sngmn7/STM32_CAN_RTOS_ETHERNET/rear_node_board/FrontZone_Carrier_설계기준.xlsx

Sheet: 00_개요
Front Zone 캐리어 보드 — 설계 기준 / 핀맵 / BOM
출처 | ZoneController_Front_H723.ioc / F407_Front.ioc (업로드본에서 직접 추출)
Rear 보드와의 차이 | MCU가 F446RET6(LQFP64) → F407VGT6(LQFP100). CAN 버스 1개. 모터 드라이버·ADC 3ch·DHT11이 새로 추가됨
MCU 구성 | U2 = STM32F407VGT6 (LQFP-100, 베어칩). H723은 Nucleo-144 모듈을 핀헤더로 연결
CAN 버스 | 250 kbit/s 1개. H723 FDCAN2(PB5/PB6) ↔ F407 CAN1(PD0/PD1) + 외부 확장 커넥터
트랜시버 | SN65HVD230D (SOIC-8, 3.3V) × 2개 — Rear 보드와 동일 부품
전원 | J1 VIN 5V → U1 AMS1117-3.3 → 3.3V. Rear 보드와 동일 구조
★ VCAP 주의 | F407VGT6(LQFP100)은 VCAP 핀이 2개 → 2.2uF를 각각 1개씩, 총 2개. Rear의 F446(1핀·4.7uF)과 다름
★ 신규 블록 | L298N급 모터 드라이버 I/F (ENA/ENB/IN1~4), ADC 3ch (조향/브레이크/가속), DHT11, 방향지시등, 헤드램프
시트 안내 | 01=F407 핀맵, 02=H723/커넥터, 03=넷리스트, 04=BOM, 05=회로 주의사항, 06=연결금지핀

Sheet: 01_F407_핀맵
MCU 핀 | 신호 (.ioc) | ioc 라벨 | 역할 | 캐리어 네트명 | 연결 대상 | 필요 수동소자 | 비고
PD1 | CAN1_TX | - | CAN 송신 | F407_CAN_TX | U4.1 (D) | R 0Ω (33Ω 대체) | 트랜시버 최단거리
PD0 | CAN1_RX | - | CAN 수신 | F407_CAN_RX | U4.4 (R) | R 0Ω
PA1 | ADC1_IN1 | STEERING_ADC | 조향 포지션 입력 | ADC_STEER | J_ADC.2 | R 1k 직렬 + C 100nF↓GND | RC 필터. 포텐셔미터 와이퍼
PC1 | ADC1_IN11 | BRAKE_ADC | 브레이크 페달 입력 | ADC_BRAKE | J_ADC.3 | R 1k + C 100nF | 동일
PC2 | ADC1_IN12 | ACCEL_ADC | 가속 페달 입력 | ADC_ACCEL | J_ADC.4 | R 1k + C 100nF | 동일
PE4 | GPIO_Output | ACT_ENA | 모터 A 인에이블(PWM) | ACT_ENA | J_MOT.1 | R 100Ω 직렬 | L298N ENA
PE5 | GPIO_Output | ACT_ENB | 모터 B 인에이블(PWM) | ACT_ENB | J_MOT.2 | R 100Ω | L298N ENB
PE12 | GPIO_Output | ACT_IN1 | 모터 A 방향1 | ACT_IN1 | J_MOT.3 | R 100Ω
PE13 | GPIO_Output | ACT_IN2 | 모터 A 방향2 | ACT_IN2 | J_MOT.4 | R 100Ω
PE14 | GPIO_Output | ACT_IN3 | 모터 B 방향1 | ACT_IN3 | J_MOT.5 | R 100Ω
PE15 | GPIO_Output | ACT_IN4 | 모터 B 방향2 | ACT_IN4 | J_MOT.6 | R 100Ω
PE7 | GPIO_Output | TURN_LEFT_LED | 좌측 방향지시등 | TURN_L | R 330Ω → LED_L → GND | R 330Ω | 12V 실제 램프면 MOSFET로 교체
PE8 | GPIO_Output | TURN_RIGHT_LED | 우측 방향지시등 | TURN_R | R 330Ω → LED_R → GND | R 330Ω | 동일
PE10 | GPIO_Output | HEADLAMP_OUT | 헤드램프 출력 | HEADLAMP | R 330Ω → LED_H → GND | R 330Ω | 동일
PE9 | GPIO_Input | TURN_SWITCH | 방향지시 스위치 | TURN_SW | SW2 → GND | R 10k↑3V3 + C 100nF + R 100Ω | ioc는 내부 PULLUP이지만 외부 풀업 권장
PE11 | GPIO_Output(OD) | DHT11_DATA | 온습도 센서 데이터 | DHT11_DATA | J_DHT.2 | R 4.7k↑3V3 (필수) | 1-wire 오픈드레인 → 풀업 없으면 통신 불가
PA13 | SWDIO | SWDIO | 디버그 | F407_SWDIO | J_SWD.4 | -
PA14 | SWCLK | SWCLK | 디버그 | F407_SWCLK | J_SWD.2 | -
PB3 | SWO | SWO | 디버그 트레이스 | F407_SWO | J_SWD.6 | -
NRST | - | - | 리셋 | F407_NRST | J_SWD.5 + SW1 | C 100nF↓GND | 리셋 버튼 옵션
BOOT0 | - | - | 부트 모드 | F407_BOOT0 | R 10k↓GND | R 10k | 플래시 부팅 고정
PB2 | GPIO_Input | BOOT1 | 부트1 | - | R 10k↓GND | R 10k | F407은 BOOT1=PB2. 풀다운 필수
PH0/PH1 | RCC_OSC_IN/OUT | - | 8MHz 크리스탈 | OSC_IN/OSC_OUT | Y1 | C 10pF × 2 | 칩 최근접 배치
VCAP_1 | - | - | 내부 레귤레이터 | VCAP1 | C 2.2uF ↓GND | 2.2uF | ★ F407은 VCAP 2개
VCAP_2 | - | - | 내부 레귤레이터 | VCAP2 | C 2.2uF ↓GND | 2.2uF | ★ 각각 별도로 달 것
VDDA/VREF+ | - | - | 아날로그 전원 | 3V3A | FB1 경유 3.3V | FB 1kΩ@100MHz + 100nF + 1uF | ADC 3ch 쓰므로 분리 권장
VDD ×여러개 | - | - | 디지털 전원 | +3.3V | 각 핀마다 100nF | 100nF × VDD 개수 | LQFP100은 VDD가 5개 내외
VSS ×여러개 | - | - | 그라운드 | GND | GND 플레인 | - | 전부 플레인 연결

Sheet: 02_커넥터
레퍼런스 | 커넥터 | 핀 수 | 핀 배열 | 용도 | 비고
J2 | H723 NUCLEO-144 I/F | 4 | 1=FDCAN2_TX(PB6), 2=FDCAN2_RX(PB5), 3=GND, 4=GND | H723 모듈 연결 | Nucleo CN12-17(PB6), CN12-29(PB5)에서 점퍼선
J3 | SWD - F407 | 6 | 1=+3.3V, 2=SWCLK, 3=GND, 4=SWDIO, 5=NRST, 6=SWO | ST-Link 디버그 | Rear 보드 J3/J4와 동일 배열
J4 | UART CONSOLE | 3 | 1=TX(PA2/USART2), 2=RX(PA3), 3=GND | 디버그 콘솔 | ※ .ioc에 USART 미설정 — 쓰려면 CubeMX에서 추가
J5 | CAN 250k 외부 | 3 | 1=CANH, 2=CANL, 3=GND | CAN 버스 확장/모터노드 | 스크류 터미널 권장
J6 | MOTOR DRIVER | 7 | 1=ENA, 2=ENB, 3=IN1, 4=IN2, 5=IN3, 6=IN4, 7=GND | L298N 등 드라이버 보드 | 드라이버 전원은 별도 공급
J7 | ADC 입력 | 5 | 1=3.3V, 2=STEER, 3=BRAKE, 4=ACCEL, 5=GND | 페달/조향 센서 | 포텐셔미터 3개
J8 | DHT11 | 3 | 1=3.3V, 2=DATA, 3=GND | 온습도 센서 | DATA에 4.7k 풀업 필수
J1 | VIN 5V | 2 | 1=VCC(5V), 2=GND | 전원 입력 | 터미널블록
J9 | 램프 출력 | 4 | 1=TURN_L, 2=TURN_R, 3=HEADLAMP, 4=GND | 외부 램프 인출 | 온보드 LED와 병렬 or 대체

Sheet: 03_넷리스트
넷명 | 블록 | 연결 1 | 연결 2 | 연결 3 | 수동소자 | 비고
CANH | CAN | U3.7 | U4.7 | J5.1 | RT1a/RT2a 60.4Ω, ESD D1 | 차동페어. 데이지체인
CANL | CAN | U3.6 | U4.6 | J5.2 | RT1b/RT2b 60.4Ω, ESD D1 | CANH와 페어 라우팅
CAN_SPLIT | CAN | 종단 중점 | C 4.7nF | GND | C 4.7nF | 스플릿 종단
H723_CAN_TX | CAN | J2.1 | U3.1 |  | R 0Ω
H723_CAN_RX | CAN | J2.2 | U3.4 |  | R 0Ω
F407_CAN_TX | CAN | U2.PD1 | U4.1 |  | R 0Ω
F407_CAN_RX | CAN | U2.PD0 | U4.4 |  | R 0Ω
VCC | 전원 | J1.1 | U1.3 (AMS IN) |  | C 10uF + 100nF | 5V 입력
+3.3V | 전원 | U1.2 (OUT) | U2 VDD 전체, U3.3, U4.3 | 각 커넥터 3.3V핀 | C 10uF + 100nF ×n | 메인 3.3V
3V3A | 전원 | FB1 출력 | U2 VDDA/VREF+ |  | FB 1k@100MHz, C 100nF+1uF | 아날로그 분리
GND | 전원 | 전 부품 GND | GND 플레인 |  | - | 단일 플레인
RS_1 / RS_2 | 모드 | U3.8 / U4.8 | GND |  | R 0Ω ×2 | 고속모드
ADC_STEER | 센서 | J7.2 | U2.PA1 |  | R 1k 직렬, C 100nF↓GND | RC 필터
ADC_BRAKE | 센서 | J7.3 | U2.PC1 |  | R 1k, C 100nF
ADC_ACCEL | 센서 | J7.4 | U2.PC2 |  | R 1k, C 100nF
DHT11_DATA | 센서 | J8.2 | U2.PE11 |  | R 4.7k → 3.3V | ★ 풀업 없으면 동작 안 함
ACT_ENA~IN4 | 구동 | J6.1~6 | U2.PE4/5/12/13/14/15 |  | R 100Ω ×6 | 직렬 보호
TURN_L | 출력 | U2.PE7 | R→LED_L→GND | J9.1 | R 330Ω
TURN_R | 출력 | U2.PE8 | R→LED_R→GND | J9.2 | R 330Ω
HEADLAMP | 출력 | U2.PE10 | R→LED_H→GND | J9.3 | R 330Ω
TURN_SW | 입력 | U2.PE9 | R 100Ω → SW2 → GND |  | R 10k↑3V3, C 100nF↓GND | 디바운스
F407_BOOT0 | 부트 | U2 BOOT0 | GND |  | R 10k | 플래시 부팅
BOOT1 | 부트 | U2.PB2 | GND |  | R 10k | ★ F407 전용, 잊기 쉬움
OSC_IN/OUT | 클럭 | U2.PH0/PH1 | Y1.1/Y1.3 |  | C 10pF ×2, Y1 GND패드 | 칩 최근접
VCAP1 / VCAP2 | 전원 | U2 VCAP_1 / VCAP_2 | GND |  | C 2.2uF ×2 | ★ 각각 별도

Sheet: 04_BOM
구분 | 레퍼런스 | 부품 | 값 / 규격 | 패키지 | 수량 | 비고
IC | U1 | AMS1117-3.3 | 5V→3.3V LDO, 1A | SOT-223 | 1 | Rear 보드와 동일
IC | U2 | STM32F407VGT6 | LQFP-100, 0.5mm 피치 | LQFP-100 | 1 | ★ 손납땜 불가 — 리플로우/SMT 서비스
IC | U3, U4 | SN65HVD230D | 3.3V CAN 트랜시버 | SOIC-8 | 2 | Rear에서 4개 썼던 것과 동일
크리스탈 | Y1 | ECS-80-10-30B-CWN-TR | 8MHz, 4패드 SMD | 3225 | 1 | Rear와 동일 부품
커패시터 | C(VCAP) | MLCC X5R/X7R 6.3V↑ | 2.2uF | 0805 | 2 | ★ VCAP_1/VCAP_2 각각
커패시터 | C(OSC) | MLCC C0G/NP0 | 10pF | 0805 | 2 | 크리스탈 로드캡
커패시터 | C(VDD) | MLCC X7R | 100nF | 0805 | 8 | VDD 핀마다 1개 + 여유
커패시터 | C(BULK) | MLCC / 탄탈 | 10uF | 0805 | 4 | 5V, 3.3V, 3V3A, 모터I/F
커패시터 | C(VDDA) | MLCC | 1uF | 0805 | 1 | 아날로그 전원
커패시터 | C(ADC) | MLCC | 100nF | 0805 | 3 | ADC RC 필터
커패시터 | C(SW/RST) | MLCC | 100nF | 0805 | 3 | 스위치 디바운스 + NRST
커패시터 | C(SPLIT) | MLCC | 4.7nF | 0805 | 2 | CAN 스플릿 종단
페라이트 | FB1 | ILHB0805ER102VGP13 | 1kΩ@100MHz, 0.5A | 0805 | 1 | VDDA 분리. Rear와 동일
저항 | RT1a/b, RT2a/b | 칩 저항 1% | 60.4Ω | 0805 | 4 | 스플릿 종단. 버스 양 끝만
저항 | R(CAN) | 칩 저항 | 0Ω (33Ω 대체) | 0805 | 4 | TXD/RXD 직렬
저항 | R(Rs) | 칩 저항 | 0Ω | 0805 | 2 | 트랜시버 8번 → GND
저항 | R(ADC) | 칩 저항 J급 | 1k | 0805 | 3 | ADC 직렬
저항 | R(DHT) | 칩 저항 | 4.7k | 0805 | 1 | ★ DHT11 풀업 필수
저항 | R(ACT) | 칩 저항 | 100Ω | 0805 | 6 | 모터 신호 직렬
저항 | R(LED) | 칩 저항 | 330Ω | 0805 | 4 | LED 전류제한 (PWR 포함)
저항 | R(PU/PD) | 칩 저항 | 10k | 0805 | 4 | BOOT0, BOOT1, TURN_SW, 여유
저항 | R(SW) | 칩 저항 | 100Ω | 0805 | 1 | 스위치 직렬 보호
LED | LED_L/R/H/PWR | LED 3mm | 황/황/백/적 | THT or 0805 | 4 | 방향지시 2 + 헤드램프 + 전원
다이오드 | D1 | PESD1CAN | CAN ESD 보호 | SOT-23 | 1 | J5 커넥터 근처
커넥터 | J1 | 스크류 터미널 2P | 5.08mm | THT | 1 | VIN 5V
커넥터 | J5 | 스크류 터미널 3P | 5.08mm | THT | 1 | CAN 외부
커넥터 | J2 | 핀헤더 4P | 2.54mm | THT | 1 | H723 I/F
커넥터 | J3 | 핀헤더 6P | 2.54mm | THT | 1 | SWD
커넥터 | J4, J8 | 핀헤더 3P | 2.54mm | THT | 2 | UART, DHT11
커넥터 | J6 | 핀헤더 7P | 2.54mm | THT | 1 | 모터 드라이버
커넥터 | J7 | 핀헤더 5P | 2.54mm | THT | 1 | ADC 입력
커넥터 | J9 | 핀헤더 4P | 2.54mm | THT | 1 | 램프 출력
스위치 | SW1, SW2 | 택트 스위치 6mm | SPST | THT | 2 | RESET, TURN
테스트 | TP1~TP6 | 테스트 포인트 | - | SMD | 6 | CANH/L, 3V3, 3V3A, 5V, GND

Sheet: 05_회로_주의사항
# | 항목 | 내용 | 우선순위
1 | ★ VCAP 2개 | F407VGT6(LQFP100)은 VCAP_1, VCAP_2 두 핀이라 2.2uF를 각각 1개씩 총 2개. Rear의 F446(VCAP 1개·4.7uF)과 혼동하면 부팅 불안정. 칩 핀에서 5mm 이내. | 필수
2 | ★ BOOT1 = PB2 | F407은 PB2가 BOOT1 겸용이다. 10k로 GND에 떨어뜨리지 않으면 부트 모드가 튈 수 있다. F446에는 없던 항목이라 빠뜨리기 쉬움. | 필수
3 | ★ DHT11 풀업 | PE11은 오픈드레인 1-wire. 4.7k 풀업을 3.3V로 넣지 않으면 통신 자체가 안 된다. 모듈형 DHT11이면 이미 있는지 확인하고 있으면 DNP. | 필수
4 | LQFP-100 실장 | 0.5mm 피치라 인두 손납땜은 사실상 불가능. SMT 서비스나 핫에어 필수. 부품 발주 시 이 부분 계획부터 세울 것. | 필수
5 | VDD 디커플링 | LQFP100은 VDD 핀이 5개 내외. 각 VDD 핀마다 100nF을 최단거리로. 하나만 달고 넘어가면 고속 스위칭에서 리셋이 걸린다. | 필수
6 | VDDA 분리 | ADC를 3채널 쓰므로 VDDA/VREF+를 페라이트비드로 3.3V에서 분리하고 100nF+1uF. 안 하면 모터 PWM 노이즈가 ADC 값에 그대로 실린다. | 필수
7 | 모터 노이즈 격리 | L298N 계열은 스위칭 노이즈가 크다. 모터 드라이버 전원은 이 보드에서 끌어오지 말고 별도 공급하고, J6는 신호+GND만. GND는 한 점에서만 합류시킬 것. | 필수
8 | CAN 종단 | 노드가 H723·F407 2개뿐이면 양 끝 = 이 보드 양쪽. 외부 모터 노드를 J5에 달면 종단 위치가 바뀐다. 전원 끄고 CANH-CANL 재서 60Ω 확인. | 필수
9 | 차동 페어 | CANH/CANL 같은 폭·같은 간격으로 나란히, 길이 ±5mm, 비아 최소. 넷클래스 CAN(0.3mm/DP 0.3·0.2)로 지정. | 필수
10 | 스텁 길이 | 버스 본선에서 트랜시버까지 30mm 이내. U3 → U4 → J5 데이지체인. T분기 금지. | 필수
11 | Rs 핀 | U3/U4 8번을 0Ω으로 GND에. 오픈으로 두면 동작 불능. | 필수
12 | 크리스탈 배치 | Y1을 PH0/PH1 핀 최근접에, 로드캡 10pF 2개도 바로 옆. 크리스탈 아래 다른 신호 배선 금지, GND로 감쌀 것. | 필수
13 | ADC 입력 보호 | 포텐셔미터 와이퍼가 튀면 ADC 핀이 상한다. 1k 직렬 + 100nF은 필터 겸 보호. 입력이 5V 스윙이면 분압 필수(F407 ADC는 3.3V 초과 금지). | 필수
14 | AMS1117 발열 | 5V→3.3V 강하에 전류가 붙으면 SOT-223이 뜨거워진다. 탭 핀 아래 구리 면적을 넓게 잡고 비아를 여러 개 박아 방열. | 권장
15 | 램프 출력 | LED 직결이면 330Ω. 실제 12V 차량 램프면 2N7002/AO3400 로우사이드 + 게이트 10k 풀다운 + 플라이백 다이오드. | 일반
16 | TURN_SW | ioc는 내부 PULLUP이지만 외부 10k+100nF+100Ω을 넣어두는 게 노이즈에 강하다. Rear 보드 PC3 때와 같은 이유. | 권장
17 | UART 콘솔 | 현재 .ioc에 USART가 설정돼 있지 않다. J4를 살리려면 CubeMX에서 USART2(PA2/PA3) 등을 먼저 활성화할 것. 아니면 J4 미실장. | 주의
18 | H723 이더넷 핀 | PA1/PA2/PA7/PC1/PC4/PC5/PG11/PG13/PB13은 Nucleo 온보드 PHY 전용. J2에서 절대 뽑지 말 것. | 필수
19 | 전원 도메인 | H723은 자기 USB로 급전. 이 보드 3.3V와 H723 3V3를 묶지 말고 GND와 CAN 신호만 공유. | 필수
20 | 실크 표기 | J6 핀 순서(ENA/ENB/IN1~4/GND)와 J7(3V3/STEER/BRAKE/ACCEL/GND)을 실크에 반드시 인쇄. 핀 많아서 실물에서 100% 헷갈린다. | 권장
21 | GND 플레인 | 4층이면 In1.Cu 통짜 GND. F.Cu에도 GND 존을 깔아야 SMD 패드가 붙는다 — Rear 보드에서 겪었던 그 문제. | 필수

Sheet: 06_연결금지핀
대상 | 핀 | 원래 용도 | 이유 | 조치
H723 (J2) | PA1, PA2, PA7, PC1, PC4, PC5, PG11, PG13, PB13 | ETH RMII | Nucleo 온보드 LAN8742 전용 | 미연결
H723 (J2) | PD8, PD9 | USART3 VCP | ST-Link 가상 COM | 미연결
H723 (J2) | PA13, PA14 | SWD | 디버거 전용 | 미연결
F407 (U2) | PA9~PA12 | USB OTG FS | .ioc에 USB Host 활성 — 안 쓸 거면 CubeMX에서 끄고, 쓸 거면 USB 커넥터 추가 필요 | 결정 필요
F407 (U2) | PA4~PA7, PC7, PC10, PC12, PE3, PE1 | I2S3 / SPI1 / LIS302DL | Discovery 보드 잔재. 베어칩에는 해당 부품 없음 | CubeMX에서 정리 권장
F407 (U2) | PB10, PC3 | I2S2 (마이크) | Discovery 마이크 잔재 | 정리 권장
F407 (U2) | PB6, PB9 | I2C1 (오디오) | Discovery 코덱용 라벨. 다른 I2C 센서에 재사용 가능 | 재활용 검토
F407 (U2) | PD12~PD15 | Discovery LED | 베어칩엔 온보드 LED 없음 — 원하면 새 LED 달아도 됨 | 선택
F407 (U2) | PA0 | B1 버튼 | Discovery 버튼 잔재 | 선택
F407 (U2) | PC0, PD5 | USB 전원 스위치/OC | Discovery 전용 | 미연결
F407 (U2) | PD4 | Audio_RST | Discovery 코덱 리셋 | 미연결
