sngmn7/STM32_CAN_RTOS_ETHERNET/rear_node_board/공용보드_추가설계_RearFront_v2.xlsx

Sheet: 00_개요
Rear / Front 공용 보드 — 기존 rear_node_board.kicad_sch에 추가할 것
출처 | rear_node_board.kicad_sch (현재 상태) + F407_Front.ioc + ZoneController_Front_H723.ioc
핵심 결론 | MCU·전원·CAN·크리스탈·SWD·UART·램프 3종은 이미 다 있음. 추가로 필요한 건 U7 쪽 10핀 + 커넥터 3개뿐
추가 핀 수 | 10개 (ADC 3 + 모터 6 + DHT11 1) — 전부 U7(NODE) 여유핀에 배치
이미 있어서 재사용 | 깜빡이 좌/우 + 브레이크등(3종 전부), 방향 스위치, CAN, 상태 LED — Front와 Rear의 램프 구성이 완전히 동일
역할 배치 원칙 | Front 모드에서는 U7 하나가 기존 F407 역할을 전부 대신함. U4는 Front 보드에서 미실장(DNP) 가능
CAN 버스 | 현재 CANH_1/CANL_1(500k, U12+U13+J5) / CANH_2/CANL_2(250k, U10+U11) 2개. Front는 250k 버스만 쓰면 됨 → 변경 없음
H723 커넥터 | J2에 FDCAN1·FDCAN2 4핀 다 나와 있음. Front H723은 FDCAN2만 쓰므로 그대로 호환 → 변경 없음
Rear에만 있는 것 | BNO085(J6/J7), HC-SR04(J11), 서보(J10) — Front에서는 미실장으로 두면 됨
Front에만 있는 것 | ADC 3ch, 모터 드라이버, DHT11 — Rear에서는 미실장으로 두면 됨. 헤드램프는 실물 LED가 없으므로 제외
시트 안내 | 01=추가 핀맵, 02=재사용 핀, 03=추가 커넥터, 04=추가 BOM, 05=주의사항, 06=U7 남는 핀

Sheet: 01_추가핀맵_U7
U7 핀번호 | 포트 | 새 넷명 | 역할 (Front) | F407 원본 핀 | 대체 기능 | 필요 수동소자 | 연결 대상 | 비고
8 | PC0 | ADC_STEER | 조향 포지션 | PA1 (IN1) | ADC1_IN10 | R 1k 직렬 + C 100nF ↓GND | J12.2 | F407은 IN1이었으나 PA1이 이미 LED_RIGHT라 IN10으로 이동
9 | PC1 | ADC_BRAKE | 브레이크 페달 | PC1 (IN11) | ADC1_IN11 | R 1k + C 100nF | J12.3 | ★ F407과 채널 번호까지 동일 — 펌웨어 그대로
10 | PC2 | ADC_ACCEL | 가속 페달 | PC2 (IN12) | ADC1_IN12 | R 1k + C 100nF | J12.4 | ★ F407과 동일
26 | PB0 | ACT_ENA | 모터 A 인에이블 | PE4 | TIM3_CH3 (PWM) | R 100Ω 직렬 | J13.1 | PWM 필요해서 타이머 채널로 배정
27 | PB1 | ACT_ENB | 모터 B 인에이블 | PE5 | TIM3_CH4 (PWM) | R 100Ω | J13.2 | ENA와 같은 TIM3라 설정 간단
33 | PB12 | ACT_IN1 | 모터 A 방향1 | PE12 | GPIO_Output | R 100Ω | J13.3
34 | PB13 | ACT_IN2 | 모터 A 방향2 | PE13 | GPIO_Output | R 100Ω | J13.4
35 | PB14 | ACT_IN3 | 모터 B 방향1 | PE14 | GPIO_Output | R 100Ω | J13.5
36 | PB15 | ACT_IN4 | 모터 B 방향2 | PE15 | GPIO_Output | R 100Ω | J13.6 | PB12~15 연속 배치라 배선·펌웨어 다 깔끔
39 | PC8 | DHT11_DATA | 온습도 데이터 | PE11 | TIM8_CH3 (캡처 가능) | R 4.7k ↑3V3 (필수) | J14.2 | ★ 풀업 없으면 통신 자체가 안 됨

Sheet: 02_재사용핀
U7 핀번호 | 포트 | 현재 넷명 (Rear) | Rear 역할 | Front 역할 | F407 원본 | 조치
14 | PA0 | LED_LEFT | 좌측 깜빡이 | 좌측 깜빡이 (PE7) | PE7 | ★ Front/Rear 둘 다 동일 기능. 넷명을 TURN_LEFT로 바꾸면 더 명확
15 | PA1 | LED_RIGHT | 우측 깜빡이 | 우측 깜빡이 (PE8) | PE8 | ★ Front/Rear 둘 다 동일 기능
11 | PC3 | TOGGLE_SW | 토글 스위치 | TURN_SWITCH | PE9 | 그대로 사용. 이미 10k 풀업+디바운스 붙어 있음
21 | PA5 | LED_STATUS | 상태 표시 | 상태 표시 | - | 그대로 사용
20 | PA4 | LED_BRAKE | 브레이크등 | 브레이크등 | - | ★ Front도 브레이크등이 있으므로 그대로 사용. Front/Rear LED 3종이 완전히 동일
44 | PA11 | F446_CAN2_RX | CAN 250k 수신 | CAN 수신 | PD0 | 그대로. Front H723도 FDCAN2(250k)라 버스 일치
45 | PA12 | F446_CAN2_TX | CAN 250k 송신 | CAN 송신 | PD1 | 그대로
16 | PA2 | UART_TX_2 | 콘솔 TX | 콘솔 TX | 미설정 | 그대로. Front .ioc엔 USART가 없으니 CubeMX에서 켜면 됨
17 | PA3 | UART_RX_2 | 콘솔 RX | 콘솔 RX | 미설정 | 그대로
46 | PA13 | ND_SWDIO | 디버그 | 디버그 | PA13 | 그대로
49 | PA14 | ND_SWCLK | 디버그 | 디버그 | PA14 | 그대로
55 | PB3 | ND_SWO | 디버그 트레이스 | 디버그 트레이스 | PB3 | 그대로
5 | PH0 | ND_OSC_IN | 8MHz | 8MHz | PH0 | 그대로. Front도 HSE 8MHz로 동일
6 | PH1 | ND_OSC_OUT | 8MHz | 8MHz | PH1 | 그대로
29 | PB10 | US_TRIG | 초음파 트리거 | 미사용 | - | Rear 전용. Front에서는 J11 미실장
58 | PB6 | US_ECHO | 초음파 에코 | 미사용 | - | Rear 전용
61 | PB8 | I2C1_SCL | IMU | 미사용 | - | Rear 전용. Front에서는 U8 소켓 미실장
62 | PB9 | I2C1_SDA | IMU | 미사용 | - | Rear 전용
56 | PB4 | BNO_RST | IMU 리셋 | 미사용 | - | Rear 전용
57 | PB5 | BNO_INT | IMU 인터럽트 | 미사용 | - | Rear 전용

Sheet: 03_추가커넥터
레퍼런스 | 이름 | 핀 수 | 핀 배열 | 용도 | 실장 조건
J12 | ADC INPUT | 5 | 1=+3.3V, 2=STEER, 3=BRAKE, 4=ACCEL, 5=GND | 페달/조향 포텐셔미터 | Front만 실장
J13 | MOTOR DRIVER | 7 | 1=ENA, 2=ENB, 3=IN1, 4=IN2, 5=IN3, 6=IN4, 7=GND | L298N 등 드라이버 | Front만 실장
J14 | DHT11 | 3 | 1=+3.3V, 2=DATA, 3=GND | 온습도 센서 | Front만 실장
- | (기존) J1~J11 | - | 변경 없음 | 전원/H723/SWD/CAN/UART/IMU/초음파/서보 | 역할별 선택 실장

Sheet: 04_추가BOM
구분 | 레퍼런스(예시) | 부품 | 값 | 패키지 | 수량 | 용도
저항 | R16~R18 | 칩 저항 J급 | 1k | 0805 | 3 | ADC 3ch 직렬 보호 + RC 필터
커패시터 | C28~C30 | MLCC X7R | 100nF | 0805 | 3 | ADC 3ch 필터 → GND
저항 | R19~R24 | 칩 저항 J급 | 100Ω | 0805 | 6 | 모터 드라이버 신호 6개 직렬 보호
저항 | R25 | 칩 저항 J급 | 4.7k | 0805 | 1 | ★ DHT11 데이터 풀업 → 3.3V
커넥터 | J12 | 핀헤더 5P | 2.54mm | THT | 1 | ADC 입력
커넥터 | J13 | 핀헤더 7P | 2.54mm | THT | 1 | 모터 드라이버
커넥터 | J14 | 핀헤더 3P | 2.54mm | THT | 1 | DHT11
저항 | R27, R28 | 칩 저항 | 1k / 2k | 0805 | 2 | ADC 5V 입력용 분압 자리 (기본 DNP)
TR | Q1~Q3 | AO3400 / 2N7002 | N-ch MOSFET | SOT-23 | 3 | 깜빡이/브레이크를 12V 실램프로 구동할 때만 (기본 DNP)

Sheet: 05_주의사항
# | 항목 | 내용 | 우선순위
1 | ★ DHT11 풀업 | PC8은 오픈드레인 1-wire. 4.7k 풀업을 3.3V로 안 넣으면 통신 자체가 안 된다. 모듈형 DHT11이면 보드에 이미 있는지 확인하고 있으면 DNP. | 필수
2 | ★ ADC 입력 전압 | F446 ADC는 3.3V 초과 입력 금지. 포텐셔미터를 보드 3.3V로 물리면 안전하지만, 5V 센서를 쓸 거면 1k/2k 분압 자리(R27/R28)를 반드시 실장할 것. 지금은 DNP로 자리만 남겨두면 됨. | 필수
3 | ★ 모터 전원 분리 | L298N 계열 드라이버 전원을 이 보드 VIN에서 끌어오지 말 것. J13은 신호 6개 + GND만. 드라이버 모터 전원은 완전 별도로 넣고, GND만 한 점에서 합류시킨다. 안 지키면 모터 스위칭 노이즈로 MCU가 리셋된다. | 필수
4 | ADC RC 필터 배치 | 1k + 100nF은 MCU 핀 쪽에 가깝게. 커넥터 쪽에 붙이면 배선이 안테나 역할을 해서 필터 의미가 없다. | 필수
5 | VDDA 이미 확보됨 | U7의 VDDA는 이미 FB2(페라이트비드) + 100nF + 1uF로 3.3V에서 분리돼 있다. ADC 3ch 추가해도 그대로 쓰면 됨 — 새로 할 일 없음. | 일반
6 | PB0/PB1 타이머 | ACT_ENA/ENB를 TIM3_CH3/CH4로 잡았다. 같은 타이머라 주파수가 공통이 되는데, 모터 2개를 다른 주파수로 돌릴 일은 없으니 문제 없음. 굳이 나누고 싶으면 ENB를 PA6(TIM3_CH1)이나 PC7(TIM8_CH2)로 옮기면 됨. | 일반
7 | PB12~15 연속 배치 | ACT_IN1~4를 PB12~15로 연속 배정해서 GPIOB->ODR 한 번으로 4비트를 동시에 쓸 수 있다. 방향 전환 시 관통전류(shoot-through)를 줄이는 데 유리. | 권장
8 | Rear/Front 미실장 목록 | Rear 보드: J12·J13·J14 미실장. Front 보드: J6·J7(IMU 소켓)·J11(초음파)·J10(서보) 미실장. 실크에 'FRONT ONLY' / 'REAR ONLY' 표기해두면 조립 실수가 없다. | 권장
9 | U4 미실장 옵션 | Front 모드에서 U7 하나가 F407 역할을 전부 대신하므로 U4는 안 써도 된다. Front 보드는 U4와 U13(그쪽 트랜시버), Y4, 관련 디커플링을 통째로 미실장하면 원가가 줄어든다. 단, 나중에 쓸 수도 있으니 패턴은 남겨둘 것. | 권장
10 | CAN 버스 선택 | Front는 H723 FDCAN2(250k) ↔ U7 CAN 조합이므로 CANH_2/CANL_2 버스만 쓴다. J5(500k 외부 모터)는 Front에서 미사용. 종단저항은 그 버스 양 끝에만 있어야 하니, U4/U13 미실장하면 500k 버스 종단은 의미가 없어진다. | 필수
11 | 넷명 통일 제안 | LED_LEFT→TURN_LEFT, LED_RIGHT→TURN_RIGHT로 바꾸면 Rear/Front 양쪽에서 의미가 통한다. 지금 바꿔두는 게 나중에 헷갈리지 않음. | 권장
12 | PC8 대안 | DHT11을 PC8(TIM8_CH3) 대신 순수 GPIO로 처리해도 된다. 대부분의 DHT11 드라이버가 DWT 딜레이 기반이라 타이머가 꼭 필요하진 않다. 타이머 캡처를 쓰고 싶을 때를 대비해 PC8을 골랐을 뿐. | 일반
13 | 램프 3종 공용 | 깜빡이 좌/우 + 브레이크등 = Front·Rear가 완전히 동일하다. PA0/PA1/PA4와 온보드 LED(D2/D3/D4)가 이미 있으므로 램프 관련해서는 추가할 회로가 전혀 없다. | 일반
14 | 커넥터 배치 | J12(ADC)·J13(모터)·J14(DHT11)은 U7 근처 보드 가장자리에. 특히 J13은 노이즈원이므로 크리스탈(Y3)과 ADC 라인에서 최대한 멀리 떨어뜨릴 것. | 권장
15 | 보드 크기 재검토 | 커넥터 4개 + 수동소자 16개가 늘어난다. 현재 외곽선에 여유가 없으면 한쪽을 10~15mm 정도 넓히는 게 배선이 편하다. | 권장

Sheet: 06_U7_남는핀
U7 핀번호 | 포트 | 대표 대체기능 | 상태 | 메모
2 | PC13 | GPIO / RTC 침입감지 | 여유 | 구동능력 약함(3mA). LED 직결 비권장
3 | PC14 | OSC32_IN | 여유 | 32.768kHz 안 쓰면 GPIO 가능하나 구동 약함
4 | PC15 | OSC32_OUT | 여유 | 동일
22 | PA6 | TIM3_CH1 / SPI1_MISO / ADC_IN6 | 여유 | ★ 추천 1순위 — PWM·SPI·ADC 다 됨
23 | PA7 | TIM3_CH2 / SPI1_MOSI / ADC_IN7 | 여유 | ★ 추천 1순위
24 | PC4 | ADC_IN14 | 여유 | ADC 4번째 채널 필요하면 여기
25 | PC5 | ADC_IN15 | 여유 | ADC 5번째 채널
37 | PC6 | TIM8_CH1 / USART6_TX | 여유 | 추가 UART 필요하면 PC6/PC7 세트
38 | PC7 | TIM8_CH2 / USART6_RX | 여유 | 동일
40 | PC9 | TIM8_CH4 / I2C3_SDA | 여유
41 | PA8 | MCO1 / TIM1_CH1 | 여유 | 헤드램프용으로 잡았다가 해제. 클럭 출력 겸용
42 | PA9 | USART1_TX / TIM1_CH2 | 여유 | 두 번째 콘솔용
43 | PA10 | USART1_RX / TIM1_CH3 | 여유 | 두 번째 콘솔용
50 | PA15 | TIM2_CH1 / SPI1_NSS | 여유 | JTDI 겸용이나 SWD만 쓰면 무관
51 | PC10 | SPI3_SCK / USART3_TX | 여유
52 | PC11 | SPI3_MISO / USART3_RX | 여유
53 | PC12 | SPI3_MOSI | 여유
54 | PD2 | GPIO | 여유 | LQFP64에서 유일한 PD 핀
59 | PB7 | I2C1_SDA(alt) / TIM4_CH2 | 여유
