sngmn7/STM32_CAN_RTOS_ETHERNET/rear_node_board/rear_node_board.pdf

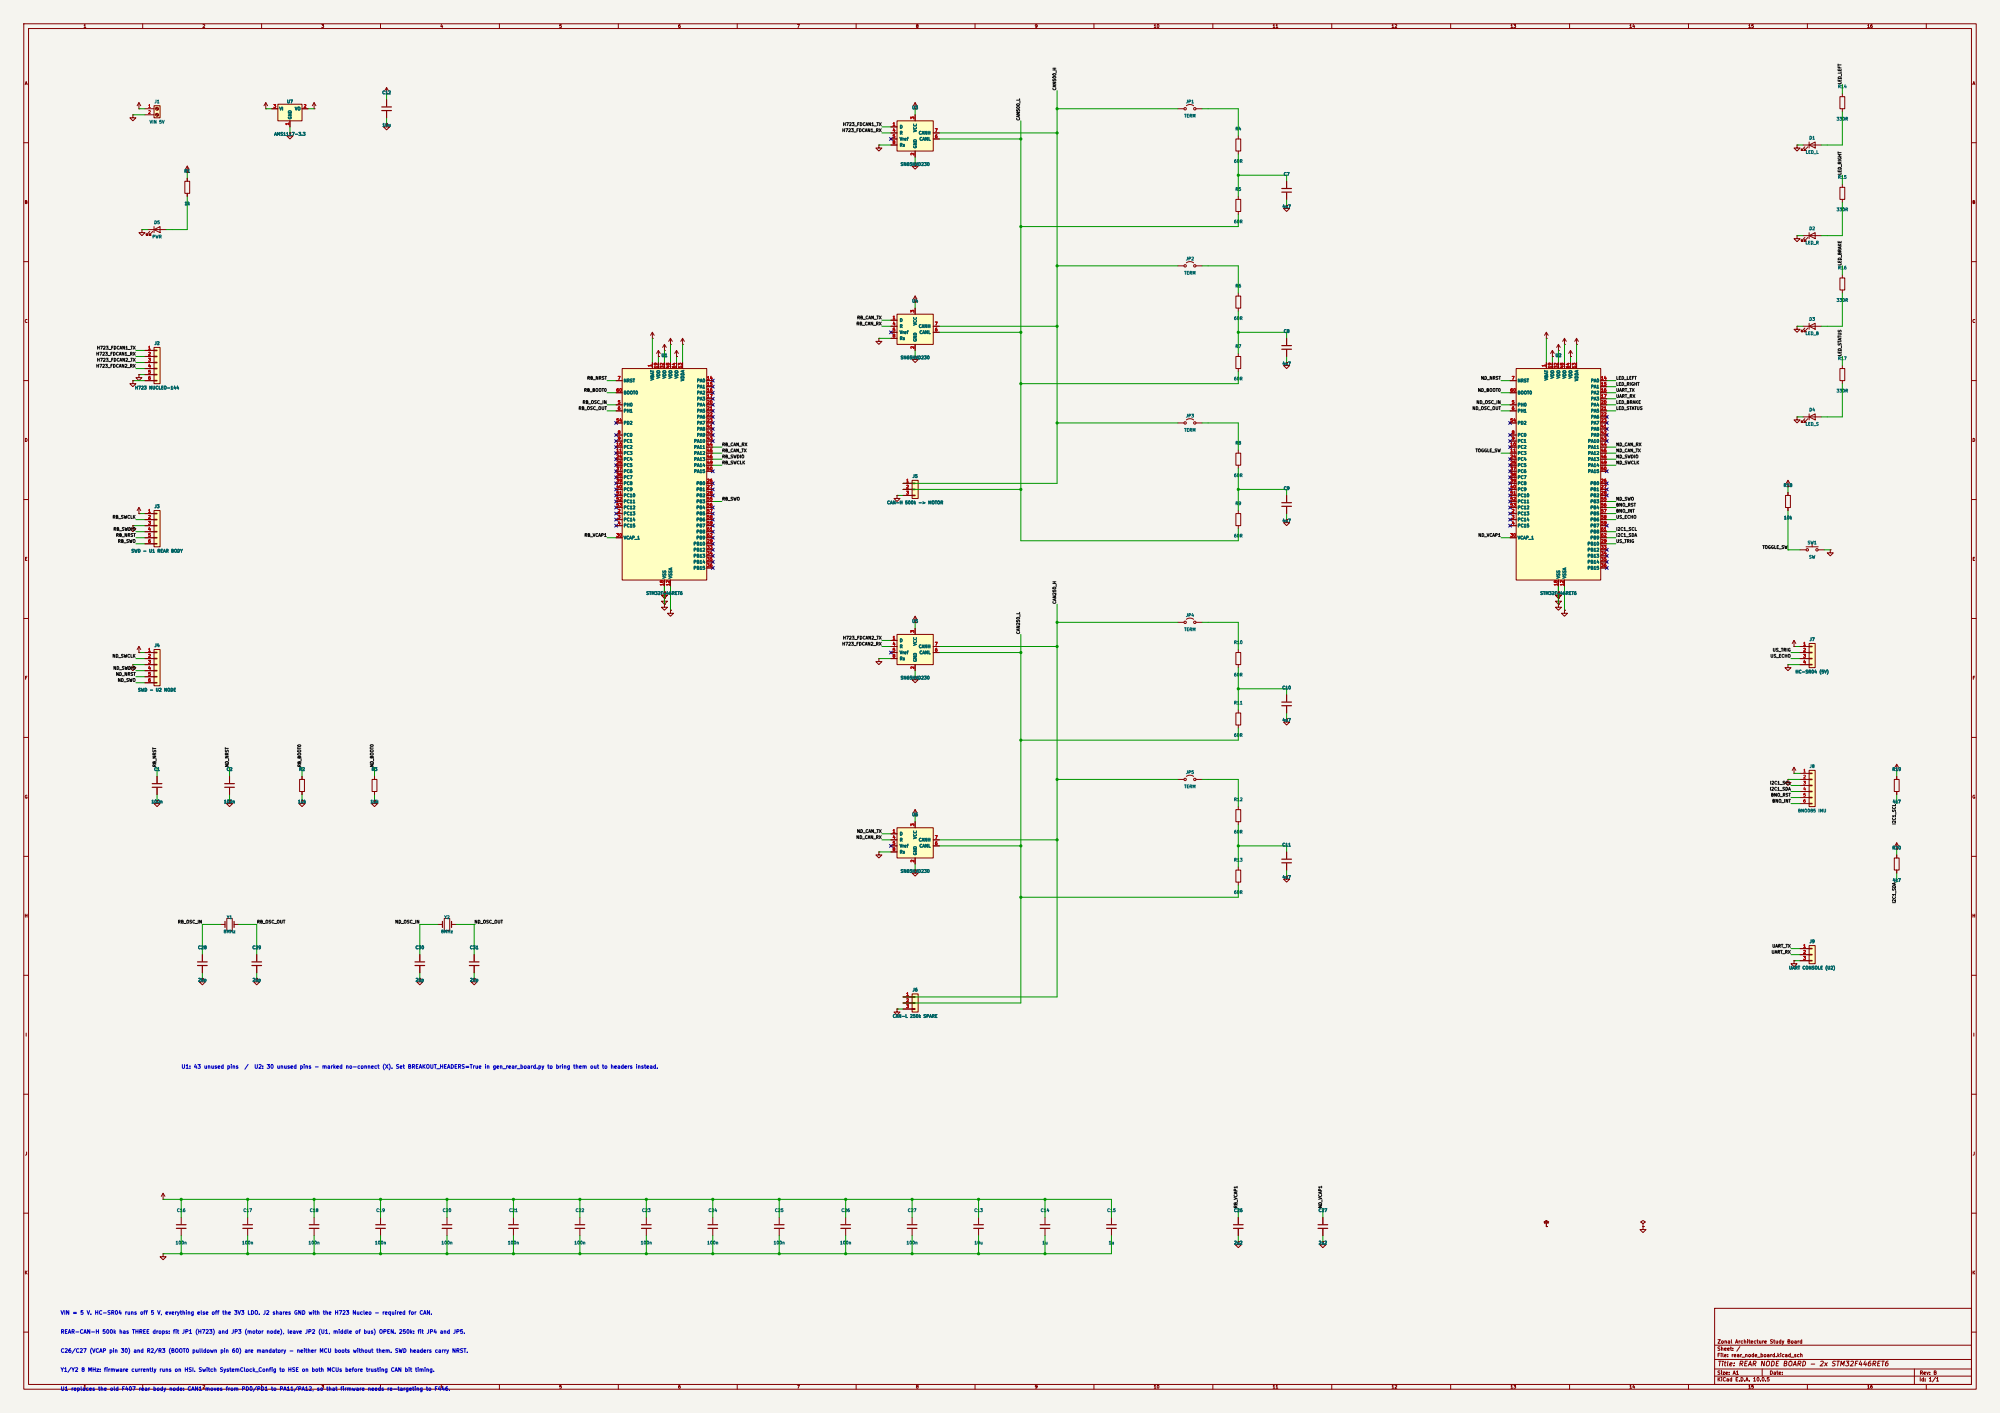
[picture p1: page 1]

U1: 43 unused pins / U2: 30 unused pins - marked no-connect (X). Set BREAKOUT_HEADERS=True in gen_rear_board.py to bring them out to headers instead.

VIN = 5 V. HC-SR04 runs off 5 V, everything else off the 3V3 LDO. J2 shares GND with the H723 Nucleo - required for CAN.

REAR-CAN-H 500k has THREE drops: fit JP1 (H723) and JP3 (motor node), leave JP2 (U1, middle of bus) OPEN. 250k: fit JP4 and JP5.

Zonal Architecture Study Board
Sheet: /
File: rear_node_board.kicad_sch
Title: REAR NODE BOARD - 2x STM32F446RET6

C26/C27 (VCAP pin 30) and R2/R3 (BOOT0 pulldown pin 60) are mandatory - neither MCU boots without them. SWD headers carry NRST.

Y1/Y2 8 MHz: firmware currently runs on HSI. Switch SystemClock_Config to HSE on both MCUs before trusting CAN bit timing.

Size: A1 | Rev: B
KiCad E.D.A. 10.0.5 | Id: 1/1

U1 replaces the old F407 rear body node: CAN1 moves from PD0/PD1 to PA11/PA12, so that firmware needs re-targeting to F446.
