sngmn7/STM32_CAN_RTOS_ETHERNET/rear_node_board/rear_node_board.kicad_pcb

## KiCad design rear_node_board/rear_node_board.kicad_pcb (2026-09-13)

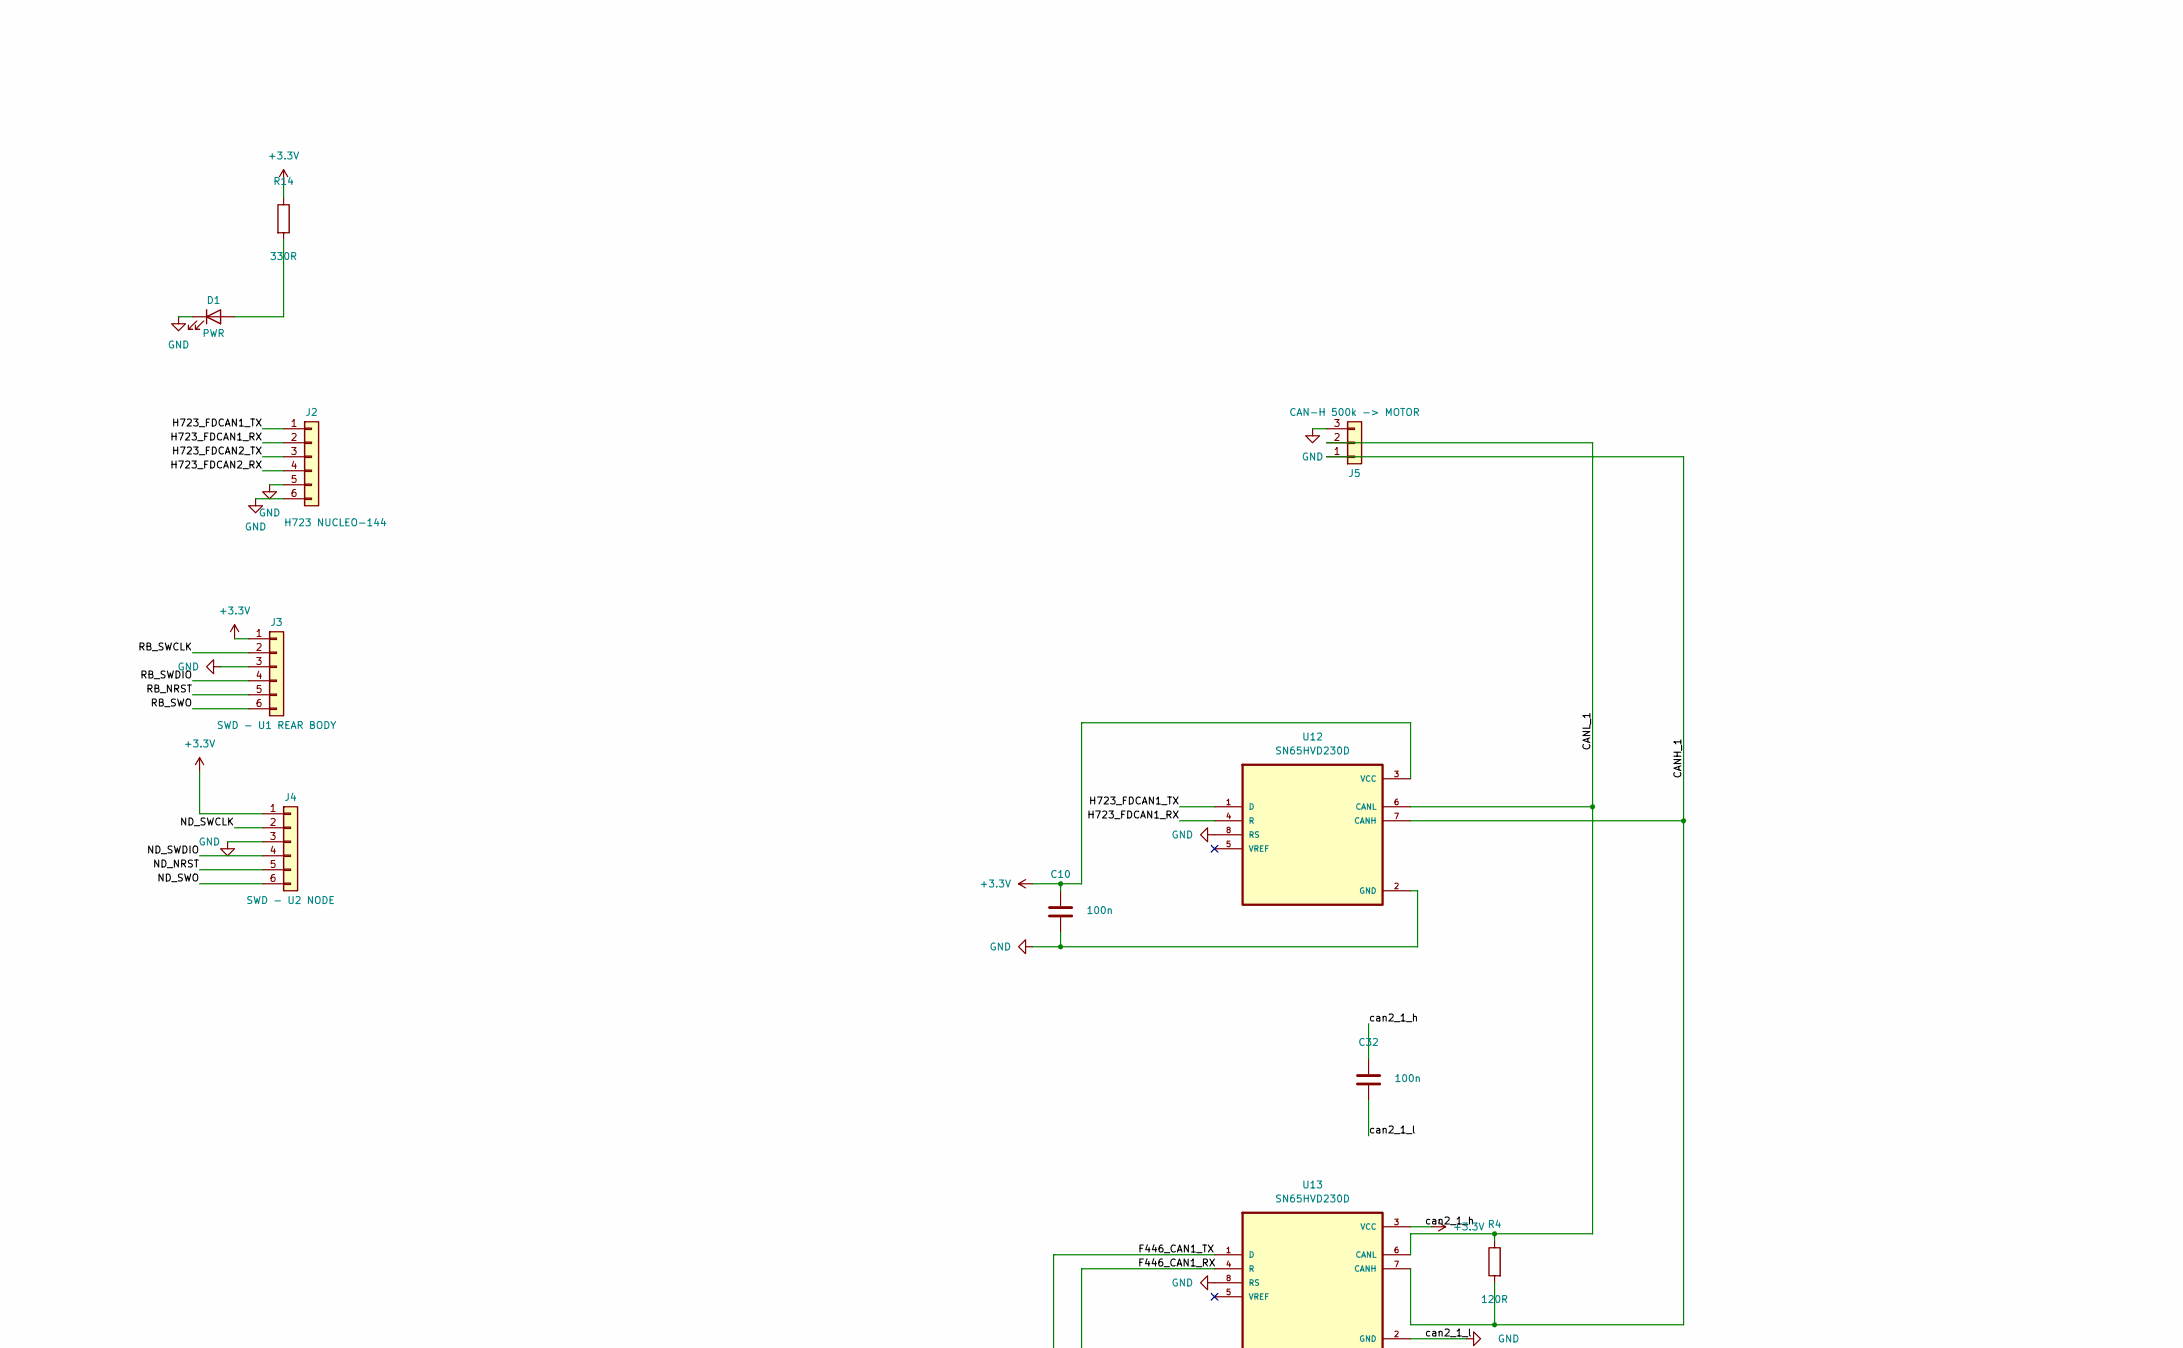
[picture p2: schematic rear_node_board.kicad_sch, REAR NODE BOARD - 2x STM32F446RET6, part in row 1, column 1]

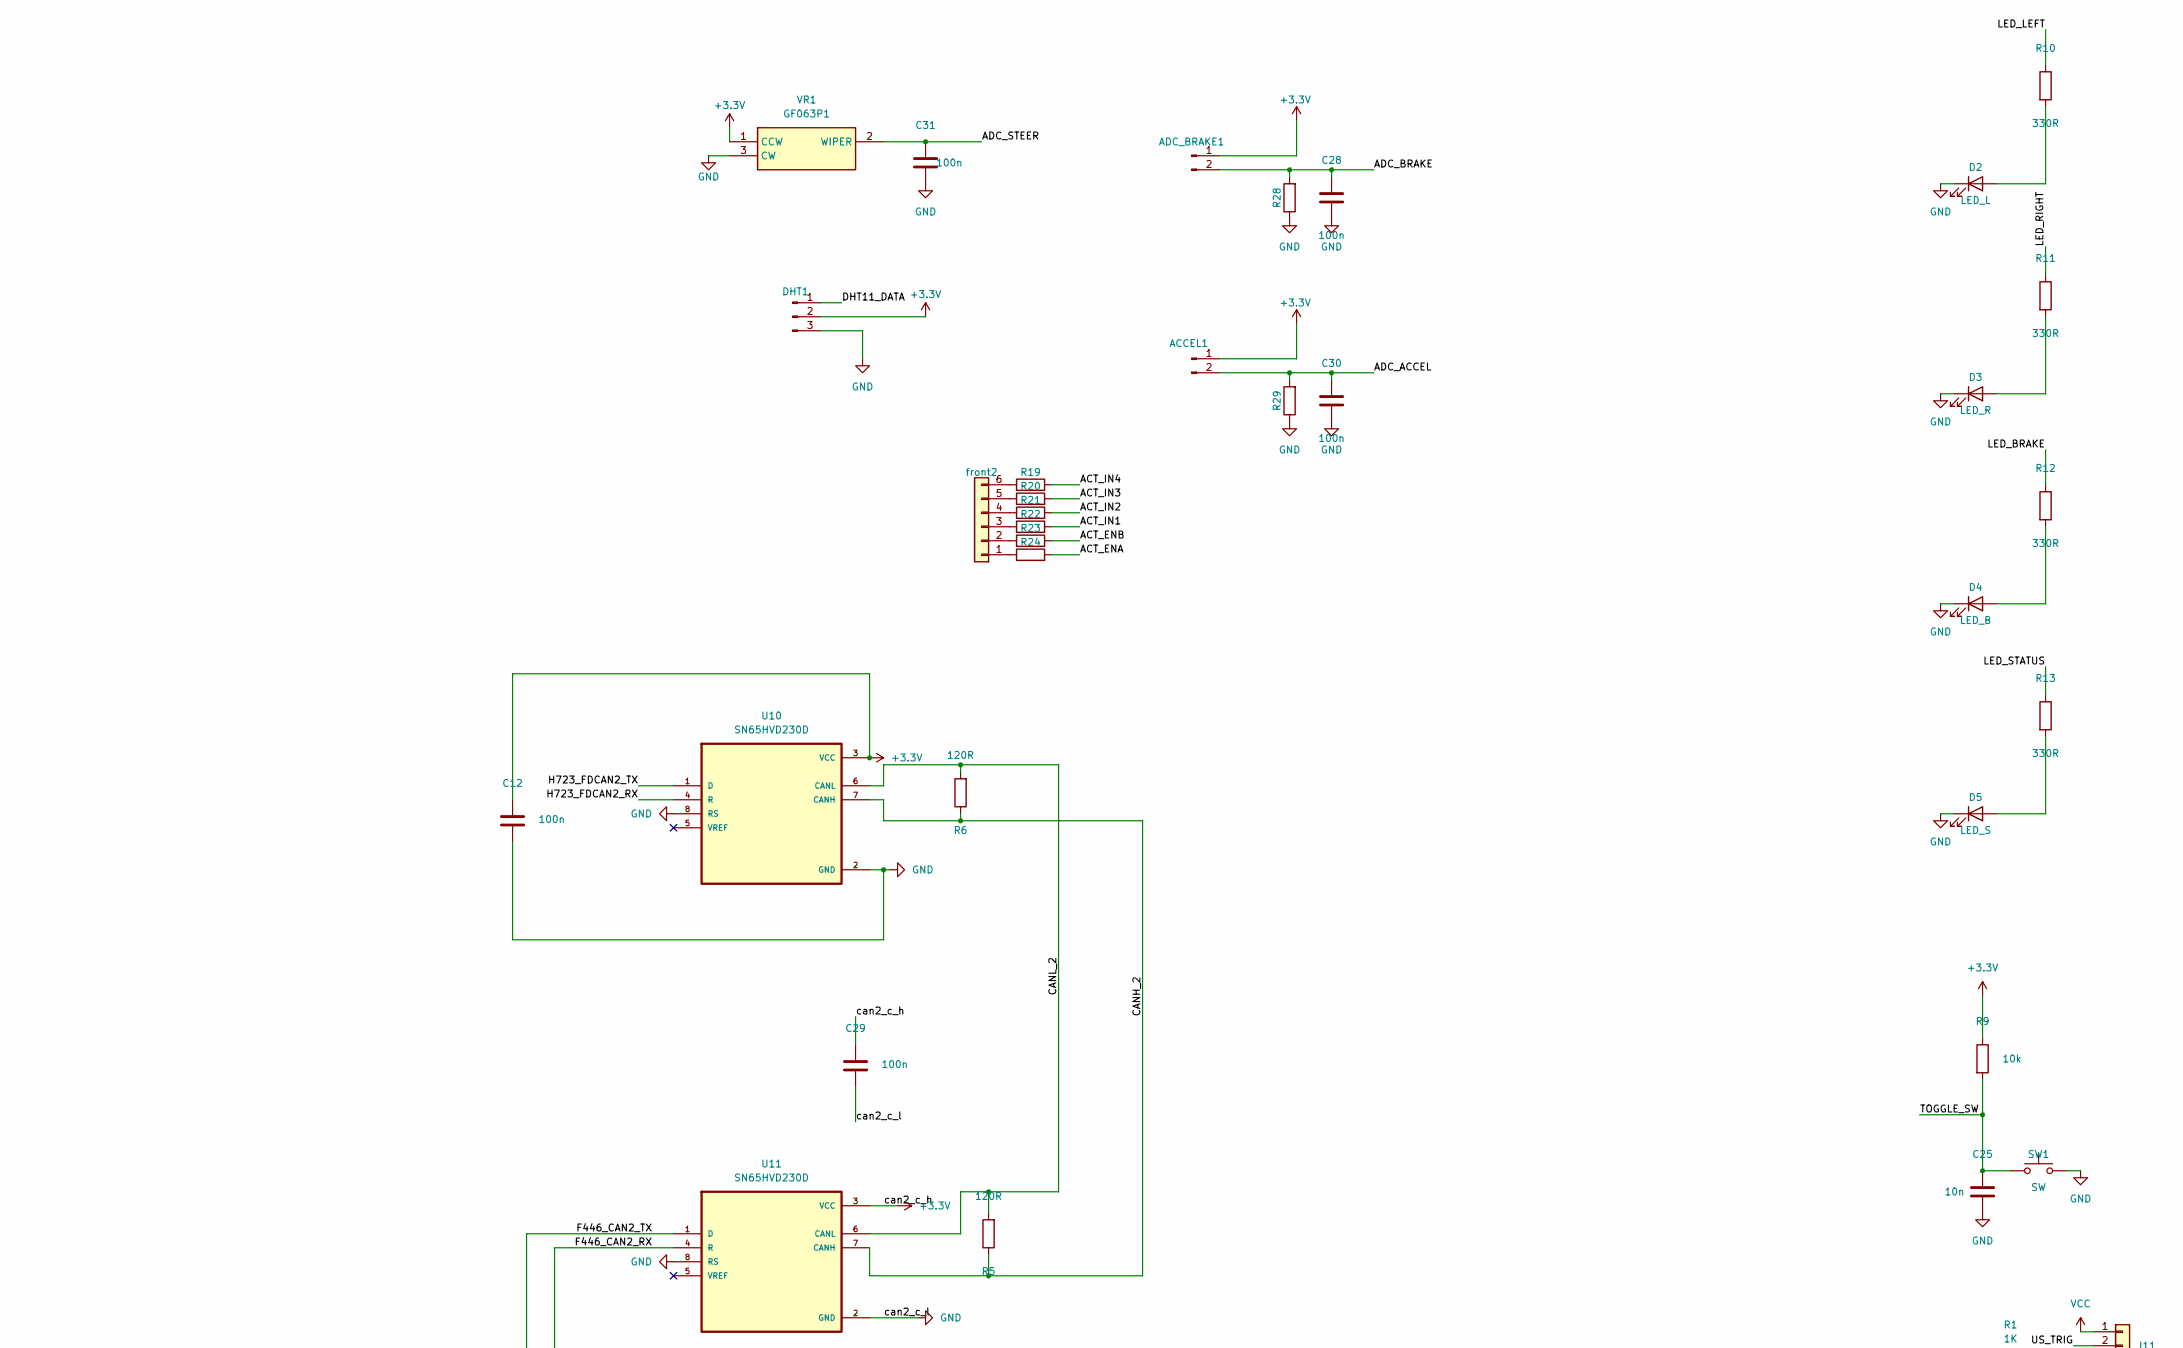
[picture p3: schematic rear_node_board.kicad_sch, REAR NODE BOARD - 2x STM32F446RET6, part in row 1, column 2]

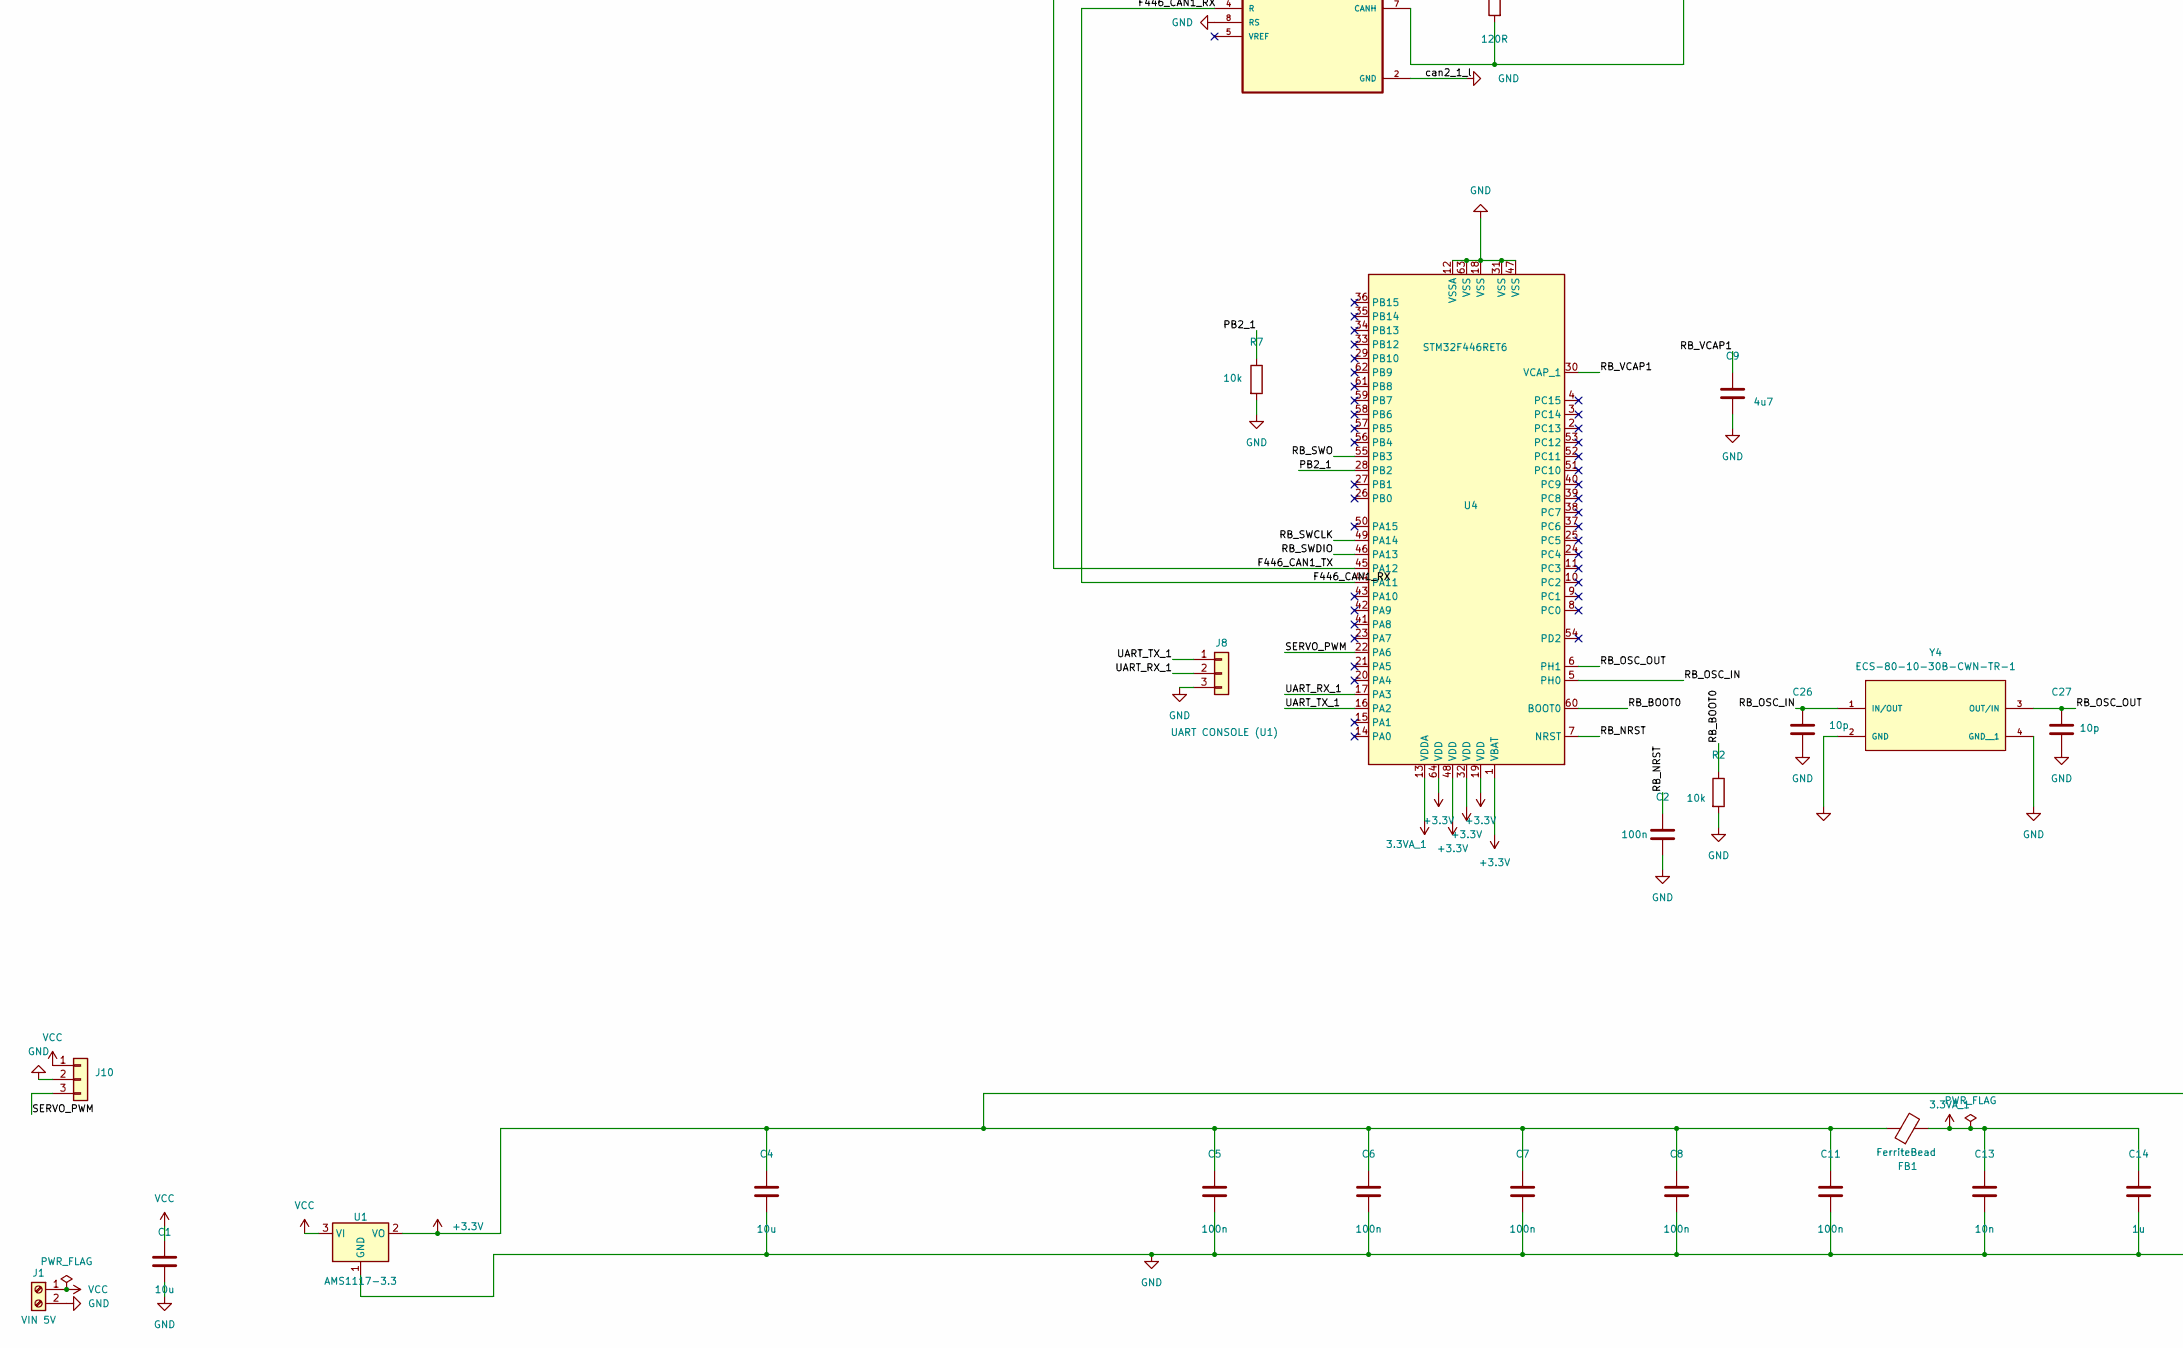
[picture p4: schematic rear_node_board.kicad_sch, REAR NODE BOARD - 2x STM32F446RET6, part in row 2, column 1]

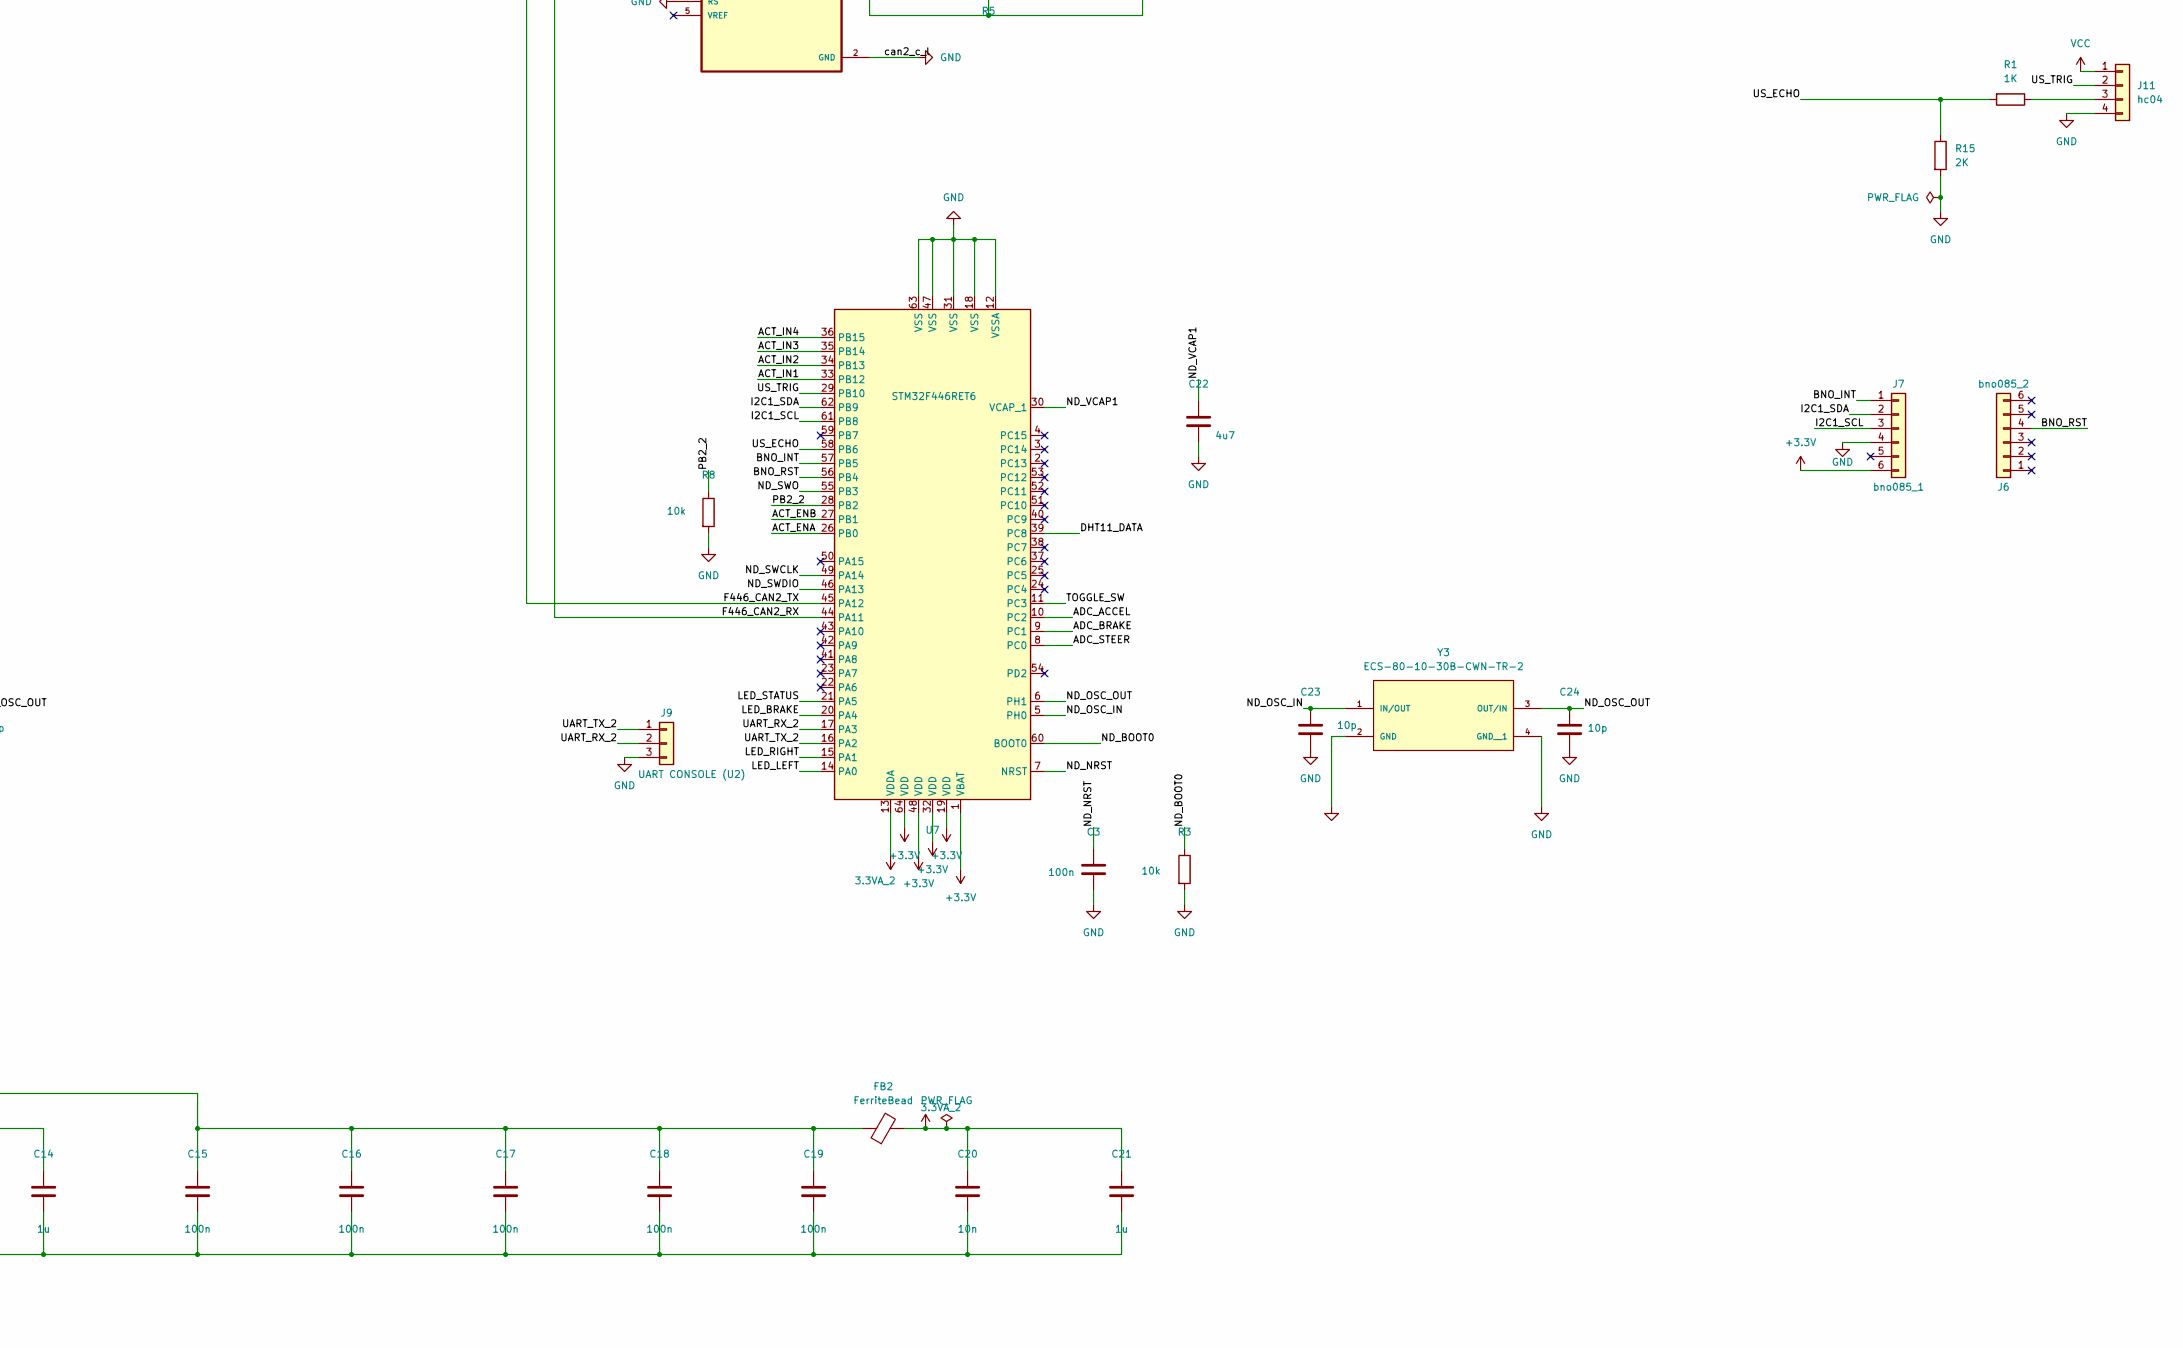
[picture p5: schematic rear_node_board.kicad_sch, REAR NODE BOARD - 2x STM32F446RET6, part in row 2, column 2]

Parts:
ACCEL1: Conn_01x02_Pin; PinHeader_1x02_P2.54mm_Vertical
ADC_BRAKE1: Conn_01x02_Pin; PinHeader_1x02_P2.54mm_Vertical
C1, C4: 10u; CP_Elec_4x5.4
C2, C3, C5, C6, C7, C8, C10, C11, C12, C15, C16, C17, C18, C19, C28, C29, C30, C31, C32: 100n; C_1206_3216Metric
C9, C22: 4u7; CP_Elec_4x5.3
C13, C20, C25: 10n; C_0603_1608Metric
C14, C21: 1u; CP_Elec_4x5.4
C23, C24, C26, C27: 10p; C_1206_3216Metric
D1: PWR; LED_D5.0mm
D2: LED_L; LED_D5.0mm
D3: LED_R; LED_D5.0mm
D4: LED_B; LED_D5.0mm
D5: LED_S; LED_D5.0mm
DHT1: Conn_01x03_Pin; PinHeader_1x03_P2.54mm_Vertical
FB1, FB2: FerriteBead; R_0805_2012Metric
J1: VIN 5V; TerminalBlock_Phoenix_MKDS-1,5-2-5.08_1x02_P5.08mm_Horizont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
J2: H723 NUCLEO-144; PinHeader_1x06_P2.54mm_Vertical
J3: SWD - U1 REAR BODY; PinHeader_1x06_P2.54mm_Vertical
J4: SWD - U2 NODE; PinHeader_1x06_P2.54mm_Vertical
J5: CAN-H 500k -> MOTOR; PinHeader_1x03_P2.54mm_Vertical
J6: bno085_2; PinHeader_1x06_P2.54mm_Vertical
J7: bno085_1; PinHeader_1x06_P2.54mm_Vertical
J8: UART CONSOLE (U1); PinHeader_1x03_P2.54mm_Vertical
J9: UART CONSOLE (U2); PinHeader_1x03_P2.54mm_Vertical
J10: Conn_01x03; PinHeader_1x03_P2.54mm_Vertical
J11: hc04; PinHeader_1x04_P2.54mm_Vertical
R1: 1K; R_0805_2012Metric
R2, R3, R7, R8, R9: 10k; R_0805_2012Metric
R4, R5, R6: 120R; R_0805_2012Metric
R10, R11, R12, R13, R14: 330R; R_0805_2012Metric
R15: 2K; R_0805_2012Metric
R19, R20, R21, R22, R23, R24: 330; R_0805_2012Metric
R28, R29: 1k; R_0805_2012Metric
SW1: SW; SW_PUSH_6mm
U1: AMS1117-3.3; SOT-223-3_TabPin2
U4, U7: STM32F446RET6; LQFP-64_10x10mm_P0.5mm
U10, U11, U12, U13: SN65HVD230D; SOIC127P599X175-8N
VR1: GF063P1; Manufacturer_Part_Number GF063P1
Y3: ECS-80-10-30B-CWN-TR-2; XTAL_ECS-80-10-30B-CWN-TR
Y4: ECS-80-10-30B-CWN-TR-1; XTAL_ECS-80-10-30B-CWN-TR
front2: Conn_01x06; PinHeader_1x06_P2.54mm_Vertical

Connections:
3.3VA_1: C13.1, C14.1, FB1.2, U4.13 (VDDA)
3.3VA_2: C20.1, C21.1, FB2.2, U7.13 (VDDA)
+3.3V: ACCEL1.1, ADC_BRAKE1.1, C4.1, C5.1, C6.1, C7.1, C8.1, C10.1, C11.1, C12.1, C15.1, C16.1, C17.1, C18.1, C19.1, C29.1, C32.1, DHT1.2, FB1.1, FB2.1, J3.1, J4.1, J7.6, R9.1, R14.1, U1.2 (VO), U4.1 (VBAT), U4.19 (VDD), U4.32 (VDD), U4.48 (VDD), U4.64 (VDD), U7.1 (VBAT), U7.19 (VDD), U7.32 (VDD), U7.48 (VDD), U7.64 (VDD), U10.3 (VCC), U11.3 (VCC), U12.3 (VCC), U13.3 (VCC), VR1.1 (CCW)
/ACT_ENA: R24.2, U7.26 (PB0)
/ACT_ENB: R23.2, U7.27 (PB1)
/ACT_IN1: R22.2, U7.33 (PB12)
/ACT_IN2: R21.2, U7.34 (PB13)
/ACT_IN3: R20.2, U7.35 (PB14)
/ACT_IN4: R19.2, U7.36 (PB15)
/ADC_ACCEL: ACCEL1.2, C30.1, R29.2, U7.10 (PC2)
/ADC_BRAKE: ADC_BRAKE1.2, C28.1, R28.2, U7.9 (PC1)
/ADC_STEER: C31.1, U7.8 (PC0), VR1.2 (WIPER)
/BNO_INT: J7.1, U7.57 (PB5)
/BNO_RST: J6.4 (Pin_4_4), U7.56 (PB4)
/CANH_1: J5.1, R4.2, U12.7 (CANH), U13.7 (CANH)
/CANH_2: R5.1, R6.1, U10.7 (CANH), U11.7 (CANH)
/CANL_1: J5.2, R4.1, U12.6 (CANL), U13.6 (CANL)
/CANL_2: R5.2, R6.2, U10.6 (CANL), U11.6 (CANL)
/DHT11_DATA: DHT1.1, U7.39 (PC8)
/F446_CAN1_RX: U4.44 (PA11), U13.4 (R)
/F446_CAN1_TX: U4.45 (PA12), U13.1 (D)
/F446_CAN2_RX: U7.44 (PA11), U11.4 (R)
/F446_CAN2_TX: U7.45 (PA12), U11.1 (D)
/H723_FDCAN1_RX: J2.2, U12.4 (R)
/H723_FDCAN1_TX: J2.1, U12.1 (D)
/H723_FDCAN2_RX: J2.4, U10.4 (R)
/H723_FDCAN2_TX: J2.3, U10.1 (D)
/I2C1_SCL: J7.3, U7.61 (PB8)
/I2C1_SDA: J7.2, U7.62 (PB9)
/LED_BRAKE: R12.1, U7.20 (PA4)
/LED_LEFT: R10.1, U7.14 (PA0)
/LED_RIGHT: R11.1, U7.15 (PA1)
/LED_STATUS: R13.1, U7.21 (PA5)
/ND_BOOT0: R3.1, U7.60 (BOOT0)
/ND_NRST: C3.1, J4.5, U7.7 (NRST)
/ND_OSC_IN: C23.1, U7.5 (PH0), Y3.1 (IN/OUT)
/ND_OSC_OUT: C24.1, U7.6 (PH1), Y3.3 (OUT/IN)
/ND_SWCLK: J4.2, U7.49 (PA14)
/ND_SWDIO: J4.4, U7.46 (PA13)
/ND_SWO: J4.6, U7.55 (PB3)
/ND_VCAP1: C22.1, U7.30 (VCAP_1)
/PB2_1: R7.1, U4.28 (PB2)
/PB2_2: R8.1, U7.28 (PB2)
/RB_BOOT0: R2.1, U4.60 (BOOT0)
/RB_NRST: C2.1, J3.5, U4.7 (NRST)
/RB_OSC_IN: C26.1, U4.5 (PH0), Y4.1 (IN/OUT)
/RB_OSC_OUT: C27.1, U4.6 (PH1), Y4.3 (OUT/IN)
/RB_SWCLK: J3.2, U4.49 (PA14)
/RB_SWDIO: J3.4, U4.46 (PA13)
/RB_SWO: J3.6, U4.55 (PB3)
/RB_VCAP1: C9.1, U4.30 (VCAP_1)
/SERVO_PWM: J10.3, U4.22 (PA6)
/TOGGLE_SW: C25.1, R9.2, SW1.1, U7.11 (PC3)
/UART_RX_1: J8.2, U4.17 (PA3)
/UART_RX_2: J9.2, U7.17 (PA3)
/UART_TX_1: J8.1, U4.16 (PA2)
/UART_TX_2: J9.1, U7.16 (PA2)
/US_ECHO: R1.2, R15.1, U7.58 (PB6)
/US_TRIG: J11.2, U7.29 (PB10)
GND: C1.2, C2.2, C3.2, C4.2, C5.2, C6.2, C7.2, C8.2, C9.2, C10.2, C11.2, C12.2, C13.2, C14.2, C15.2, C16.2, C17.2, C18.2, C19.2, C20.2, C21.2, C22.2, C23.2, C24.2, C25.2, C26.2, C27.2, C28.2, C29.2, C30.2, C31.2, C32.2, D1.1 (K), D2.1 (K), D3.1 (K), D4.1 (K), D5.1 (K), DHT1.3, J1.2, J2.5, J2.6, J3.3, J4.3, J5.3, J7.4, J8.3, J9.3, J10.2, J11.4, R2.2, R3.2, R7.2, R8.2, R15.2, R28.1, R29.1, SW1.2, U1.1 (GND), U4.12 (VSSA), U4.18 (VSS), U4.31 (VSS), U4.47 (VSS), U4.63 (VSS), U7.12 (VSSA), U7.18 (VSS), U7.31 (VSS), U7.47 (VSS), U7.63 (VSS), U10.2 (GND), U10.8 (RS), U11.2 (GND), U11.8 (RS), U12.2 (GND), U12.8 (RS), U13.2 (GND), U13.8 (RS), VR1.3 (CW), Y3.2 (GND), Y3.4 (GND__1), Y4.2 (GND), Y4.4 (GND__1)
unnamed: D1.2 (A), R14.2
unnamed: D2.2 (A), R10.2
unnamed: D3.2 (A), R11.2
unnamed: D4.2 (A), R12.2
unnamed: D5.2 (A), R13.2
unnamed: J11.3, R1.1
unnamed: R24.1, front2.1
unnamed: R23.1, front2.2
unnamed: R22.1, front2.3
unnamed: R21.1, front2.4
unnamed: R20.1, front2.5
unnamed: R19.1, front2.6
VCC: C1.1, J1.1, J10.1, J11.1, U1.3 (VI)

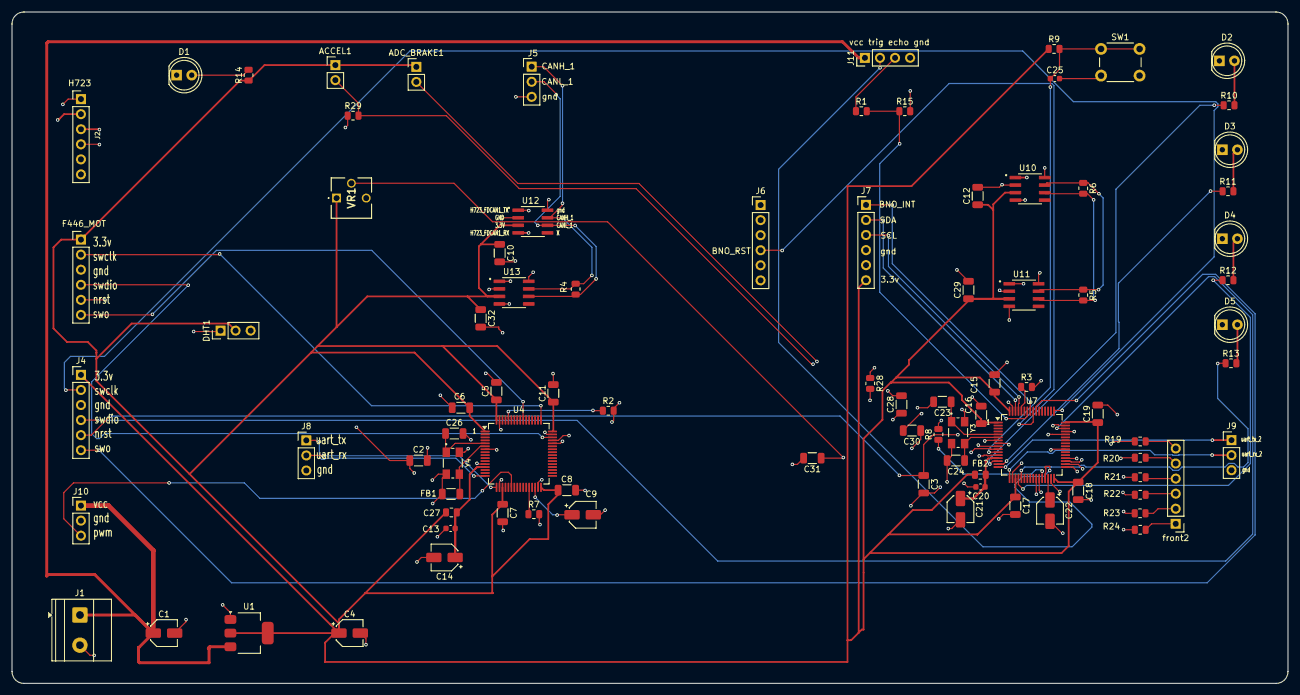
[picture p6: board rear_node_board.kicad_pcb from above]

Board: 4 copper layers, 215.1 x 113.2 mm, 88 parts (0 on the bottom side), 73 nets.
