sngmn7/STM32_CAN_RTOS_ETHERNET/(commit log)

2026-07-23 Initial commit: stm32_test_h723zg CubeIDE project
2026-07-23 Add H723ZG STM32CubeIDE project
2026-07-23 Add H723ZG, F407G, F446RE STM32CubeIDE projects
2026-07-23 Remove commute and stm32_imupart from repo
2026-07-23 Add STM32_H723ZG_REAR_JAEMIN project
2026-07-24 Replace H723ZG_REAR/JAEMIN with ETHERNET_UDP and ONLY_CAN projects
    [main.c, main.h]
2026-08-01 feat: Zonal Architecture CAN-UDP-Ethernet + Jetson Device Driver
2026-08-01 remove: delete old STM32 folders
2026-09-13 Add PCB design and debug journal
    [FrontZone_Carrier_설계기준.xlsx, dtc.csv, exec_time.csv, exec_time_measured.csv, exec_time_rtos.csv, inject12.csv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]
