sngmn7/STM32_CAN_RTOS_ETHERNET/(notices)

Notices in the files:
DEBUG_JOURNAL_최종/tools/front_pre_cubemx/Core/Src/main.c:
Copyright (c) 2026 STMicroelectronics.
All rights reserved.
This software is licensed under terms that can be found in the LICENSE file
